Emilie16/HiRel/TODOList.txt

Documentation:
	Analyse des performances attendues	:	Yann	
	Schéma électrique			:	Yann OK	
	Routage					:	Yann OK
	FMECA					:	Yann OK	
	Analyse de stress des composants (PSA)	:	Yann OK
	Dimmensionnement du filtre passe-bas	:	Yann OK	
	Circuit de mesure de rotation à 
	redondance froide			:	Yann OK
	Nombre de pannes par milliard d'heures	:	Yann OK
	Environnement des test			: 	Yann OK	
	Plan de test				:	Yann OK	
	Procédure de test			:	Yann OK

	Choix du capteur			:	Emilie	OK
	Schéma bloc de la chaîne de mesure	:	Emilie	OK
	Budget de la chaîne de mesure		:	Emilie	OK
	Dissipation de chaleur			:	Emilie	OK
	Analyse Monté-Carlo			:	Emilie	OK
	Détermination des paramètres à 
	considérer				:	Emilie 	OK
	Détermination des performances à
	analyser				:	Emilie 	OK
	Évaluation des résultats		:	Emilie 	OK
	Simulation VHDL				:	Emilie	OK
	Matrice de conformité			: 	Emilie	OK
	Banc de test				: 	Emilie	OK	
	Circuit AMBA				:	Emilie	OK
	Simulation du circuit AMBA		:	Emilie	OK
	Périphérique pour convertisseur A/D	:	Emilie	OK
	Machine d'état du contrôleur ADC	:	Emilie	OK
	Codage de la machine d'états		:	Emilie	OK
	Registre à décalage			:	Emilie	OK
	Machine d'état avec contraintes SEU	:	Emilie	OK
	Décodeur de Hamming			:	Emilie	OK
	Estimation du taux de SEU par jour	:	Emilie	OK
	Alimentation FPGA			:	Emilie	OK
	Entrées / sorties du circuit		:	Emilie	OK
