Emilie16/HiRel/HiRelRapport_CourantTension_Maret_Gsponer/PSA/Table_PSA.xls

Circuit Name | Item | Type - Value | Parameter | Rated Value | Derating | Allowed Value | Value | Stress | Status
CanSat_sensor | R16 | Résistance 0.1 ohms 0.5W | V_max | 100 V | 80% | 80 V | 5 V | 6.2% | ok
 |  |  | Pwd_max | 500 mW | 50% | 250 mW | 240.00 mW | 96.0% | ok
 |  |  | Tcase_max | 155 °C | - | 110 °C | 80.2 °C | 72.9% | ok
CanSat_sensor | R17,R19 | Résistance 100 ohms | V_max | 150 V | 80% | 120 V | 5 V | 4.2% | ok
 |  |  | Pwd_max | 125 mW | 50% | 62.5 mW | 1.00 mW | 1.6% | ok
 |  |  | Tcase_max | 155 °C | - | 110 °C | 80.2 °C | 72.9% | ok
CanSat_sensor | R18,R20 | Résistance 20k | V_max | 150 V | 80% | 120 V | 5 V | 4.2% | ok
 |  |  | Pwd_max | 125 mW | 50% | 62.5 mW | 1.00 mW | 1.6% | ok
 |  |  | Tcase_max | 155 °C | - | 110 °C | 80.2 °C | 72.9% | ok
CanSat_sensor | R8..15 | Résistance 47 ohms | V_max | 150 V | 80% | 120 V | 5 V | 4.2% | ok
 |  |  | Pwd_max | 125 mW | 50% | 62.5 mW | 5.00 mW | 8.0% | ok
 |  |  | Tcase_max | 155 °C | - | 110 °C | 80.2 °C | 72.9% | ok
CanSat_sensor | R5 | Résistance 1k | V_max | 150 V | 80% | 120 V | 5 V | 4.2% | ok
 |  |  | Pwd_max | 125 mW | 50% | 62.5 mW | 10.00 mW | 16.0% | ok
 |  |  | Tcase_max | 155 °C | - | 110 °C | 80.2 °C | 72.9% | ok
CanSat_sensor | R2 | Résistance 24k | V_max | 150 V | 80% | 120 V | 3.3 V | 2.8% | ok
 |  |  | Pwd_max | 125 mW | 50% | 62.5 mW | 1.00 mW | 1.6% | ok
 |  |  | Tcase_max | 155 °C | - | 110 °C | 80.2 °C | 72.9% | ok
CanSat_sensor | R6,R7,R1 | Résistance 75k | V_max | 150 V | 80% | 120 V | 5 V | 4.2% | ok
 |  |  | Pwd_max | 125 mW | 50% | 62.5 mW | 10.00 mW | 16.0% | ok
 |  |  | Tcase_max | 155 °C | - | 110 °C | 80.2 °C | 72.9% | ok
CanSat_sensor | R3,R4 | Résistance 270 ohms | V_max | 150 V | 80% | 120 V | 5 V | 4.2% | ok
 |  |  | Pwd_max | 330 mW | 50% | 165 mW | 1.00 mW | 0.6% | ok
 |  |  | Tcase_max | 155 °C | - | 110 °C | 80.2 °C | 72.9% | ok
CanSat_sensor | C10 | Condensateur Tantal 1uF | V_max | 20 V | 60% | 12 V | 5 V | 41.7% | ok
 |  |  | Tcase_max | 125 °C | - | 110 °C | 76 °C | 69.1% | ok
CanSat_sensor | C13 | Condensateur Tantal 100uF | V_max | 6.3 V | 60% | 3.78 V | 5 V | 132.3% | Nok
 |  |  | Tcase_max | 125 °C | - | 110 °C | 76 °C | 69.1% | ok
CanSat_sensor | C9,C11 | Condensateur Tantal 2.2uF | V_max | 16 V | 60% | 9.6 V | 10 V | 104.2% | Nok
 |  |  | Tcase_max | 125 °C | - | 110 °C | 76 °C | 69.1% | ok
CanSat_sensor | C7,C8 | Condensateur céramique 3.3uF | V_max | 16 V | 60% | 9.6 V | 5 V | 52.1% | ok
 |  |  | Tcase_max | 125 °C | - | 110 °C | 76 °C | 69.1% | ok
CanSat_sensor | C4 | Condensateur céramique 100pF | V_max | 50 V | 60% | 30 V | 5 V | 16.7% | ok
 |  |  | Tcase_max | 125 °C | - | 110 °C | 76 °C | 69.1% | ok
CanSat_sensor | C6,C14,C15,C16,C17,C19 | Condensateur céramique 100nF | V_max | 25 V | 60% | 15 V | 5 V | 33.3% | ok
 |  |  | Tcase_max | 125 °C | - | 110 °C | 76 °C | 69.1% | ok
CanSat_sensor | C12,C18,C2 | Condensateur céramique 1uF | V_max | 16 V | 60% | 9.6 V | 5 V | 52.1% | ok
 |  |  | Tcase_max | 125 °C | - | 110 °C | 76 °C | 69.1% | ok
CanSat_sensor | C1,C3,C5 | Condensateur céramique 4.7uF | V_max | 16 V | 60% | 9.6 V | 5 V | 52.1% | ok
 |  |  | Tcase_max | 125 °C | - | 110 °C | 76 °C | 69.1% | ok
CanSat_sensor | U6 | OP184 | Vpos_max | 36 V | 90% | 32.4 V | 5 V | 15.4% | ok
 |  |  | Iout_max | 10.00 mA | 80% | 8 mA | 5 mA | 62.5% | ok
 |  |  | Tj_max | 150 °C | - | 110 °C | 76.4 °C | 69.5% | ok
 |  |  | Pwd_max | 100 mW | 80% | 80 mW | 50.00 mW | 62.5% | ok
 |  |  | Tcase_max | 125 °C | - | 125 °C | 86 °C | 68.8% | ok
 |  |  | Vin_max | 36 V | 70% | 25.2 V | 5 V | 19.8% | ok
CanSat_sensor | U5 | Convertisseur A/D ADS1282-HT | Vpos_max | 5.25 V | 90% | 4.725 V | 5 V | 105.8% | Nok
 |  |  | Pwd_max | 56 mW | 90% | 50.4 mW | 50.00 mW | 99.2% | ok
 |  |  | Tcase_max | 210 °C | - | 210 °C | 86 °C | 41.0% | ok
 |  |  | Vin_max | 5 V | <=Vsupply |  | 5 V |  | ok
 |  |  | Iout_max |  | 80% | 0 mA | SPI | #VALUE! | Nok
CanSat_sensor | U3 | MAX865 | Vpos_max | 24 V | 90% | 21.6 V | 5 V | 23.1% | ok
 |  |  | Iout_max | 20.00 mA | 80% | 16 mA | 10 mA | 62.5% | ok
 |  |  | Tj_max | 160 °C | - | 110 °C | 76.4 °C | 69.5% | ok
 |  |  | Pwd_max | 330 mW | 25% | 82.5 mW | 50.00 mW | 60.6% | ok
 |  |  | Tcase_max | 125 °C | - | 125 °C | 86 °C | 68.8% | ok
 |  |  | Vin_max | 6.2 V | 100% | 6.2 V | 5 V | 80.6% | ok
CanSat_sensor | U4 | MAX6350 | Vpos_max | 40 V | 90% | 36 V | 5 V | 13.9% | ok
 |  |  | Iout_max | 15.00 mA | 80% | 12 mA | 10 mA | 83.3% | ok
 |  |  | Tj_max | 150 °C | - | 110 °C | 76.4 °C | 69.5% | ok
 |  |  | Pwd_max | 727 mW | 25% | 181.75 mW | 75.00 mW | 41.3% | ok
 |  |  | Tcase_max | 125 °C | - | 125 °C | 86 °C | 68.8% | ok
CanSat_sensor | U2 | FTDI FT232RL | Vpos_max | 6 V | 90% | 5.4 V | 5 V | 92.6% | ok
 |  |  | Iout_max | 24.00 mA | 80% | 19.2 mA | 10 mA | 52.1% | ok
 |  |  | Tj_max | 150 °C | - | 110 °C | 76.4 °C | 69.5% | ok
 |  |  | Pwd_max | 500 mW | 80% | 400 mW | 50.00 mW | 12.5% | ok
 |  |  | Tcase_max | 85 °C | - | 85 °C | 85 °C | 100.0% | ok
 |  |  | Vin_max | 6.5 V | <=Vsupply |  | 5 V |  | ok
CanSat_sensor | U1 | AP7361 | Vpos_max | 6.5 V | 90% | 5.85 V | 5 V | 85.5% | ok
 |  |  | Iout_max | 1000.00 mA | 80% | 800 mA | 15 mA | 1.9% | ok
 |  |  | Tj_max | 150 °C | - | 110 °C | 76.4 °C | 69.5% | ok
 |  |  | Pwd_max | 1100 mW | 25% | 275 mW | 100.00 mW | 36.4% | ok
 |  |  | Tcase_max | 125 °C | - | 125 °C | 86 °C | 68.8% | ok
 |  |  | Vin_max | 6.8 V | <=Vsupply |  | 5 V |  | ok
CanSat_sensor | D1,D2 | LED verte | Vrev_max | 5 V | 75% | 3.75 V | 5 V | 133.3% | Nok
 |  |  | Tj_max | 85 °C |  | 110 °C | 76 °C |  | Nok
 |  |  | Pwd_max | 60 mW | 50% | 30 mW | 40.00 mW | 133.3% | Nok
 |  |  | I_max | 25.00 mA | 50% | 12.5 mA | 11.00 mA | 88.0% | ok
CanSat_sensor | J1 | USB Connectors 5P MINI TYPE B | I_max | 1800.00 mA | 50% | 900 mA | 500.00 mA | 55.6% | ok
CanSat_sensor | P1 | Header 3 positions | I_max | 3000.00 mA | 50% | 1500 mA | 300.00 mA | 20.0% | ok
CanSat_sensor | BOT,TOP | Header 2rows 6positions 2.54mm | I_max | 3000.00 mA | 50% | 1500 mA | 20.00 mA | 1.3% | ok
CanSat_sensor | 5V,GND,3.3V,SHU,cur,char,ref | Pointes de test | I_max | 1000.00 mA | 50% |  | 10.00 mA |  | ok
