Emilie16/HiRel/HiRelRapport_CourantTension_Maret_Gsponer/VHDL/CanSat/ads1282_tb.pdf

Package List
LIBRARY ieee;
USE ieee.std_logic_1164.all; USE ieee.numeric_std.ALL;

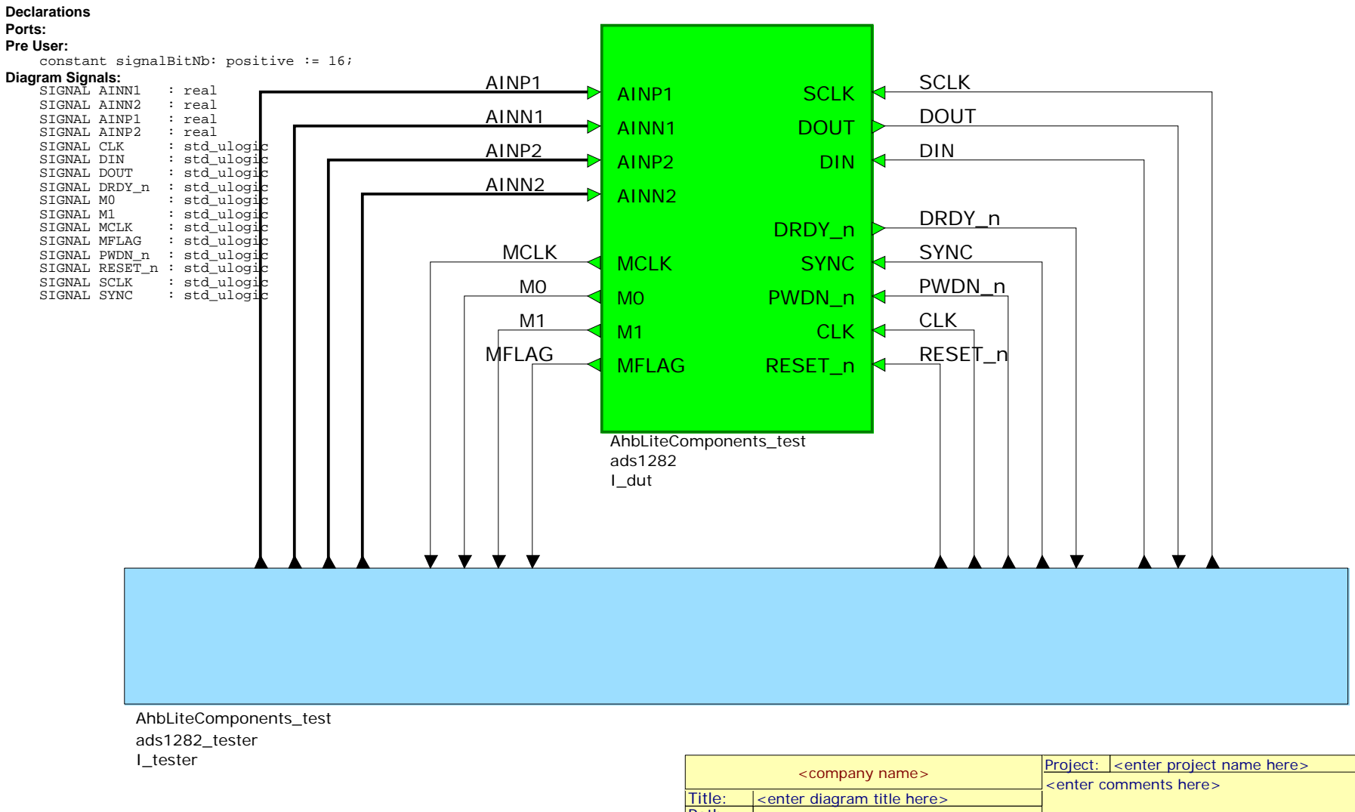
[picture p46: figure]
AhbLiteComponents_test ads1282 I_dut; RESET_n; AINP1; AINN1; AINP2; AINN2; MCLK; MFLAG MFLAG; constant signalBitNb: positive := 16;; SIGNAL AINP1; : real; Declarations Ports: Pre User:; Diagram Signals:; SIGNAL AINN2; SIGNAL AINN1; SIGNAL RESET_n : std_ulogic; SIGNAL CLK; : std_ulogic; SIGNAL PWDN_n : std_ulogic; SIGNAL SYNC; SIGNAL DRDY_n : std_ulogic; SIGNAL DIN; SIGNAL DOUT; SIGNAL SCLK; SIGNAL MFLAG; SIGNAL M1; SIGNAL M0; SIGNAL MCLK; SIGNAL AINP2; CLK; DOUT; SCLK; SYNC; DRDY_n; DIN; PWDN_n; AhbLiteComponents_test ads1282_tester I_tester; Project:; Title:; <enter diagram title here>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

Path: | <<-- more -->>
Edited: | by francois on 07 avr. 2016

<enter project name here> <company name>

AhbLiteComponents_test/ads1282_tb/struct

Printed by francois on 14.04.2016 at 14:47:43 | Page 1 of 1
