Emilie16/HiRel/HiRelRapport_CourantTension_Maret_Gsponer/EffetRadiations/SEU.xls

 |  | Part Type : Slide exercise
LET_th [MeV/mg/cm2] |  | 60
Area for 1 bit [cm2/bit] |  | 2e-07
Environment: |  | METOP
 |  | Flux /m2 /sr /s | Flux /m2 /sr /MeV | Flux /cm2/day | SEU /bit/day
Galactic cosmic rays, for LETth = 60 |  | 1.5e-08 |  | 1.628601632e-06 | 3.257203263e-13
Solar flare, for LETth = 60 |  | 2e-05 |  | 0.002171468842 | 4.342937684e-10
Total events for non permanent flux [/bit/day] |  | 4.342937684e-10
Total events for continuous flux [/bit/day] |  | 3.257203263e-13
SEU rate for the mission (5 years, 5 days solar flare) [/bit/day] |  | 1.510777803e-12
PARAMETERS | BIT QTY | SEU / DAY
Registres: (4*32bits) | 128 | 1.933795588e-10
FSM: 10bit | 10 | 1.510777803e-11
Compteur: 32bits | 32 | 4.834488971e-11
Total SEU/day for the mission (5 years, 5 days solar flare) | 170 | 2.568322266e-10
