Emilie16/HiRel/HiRelRapport_CourantTension_Maret_Gsponer/WCA/AnalyseMonteCarlo_Shunt.xls

MonteCarlito 1.05
Martin Auer, 2004, 2005
Distributed under terms of GNU General Public License
www.montecarlito.com
Instructions: |  |  |  |  | Examples:
1. Put all N formulas you want to simulate next to each other, preceded by the number of trials you want to run. |  |  |  |  | a) Select range I11:K13; press Ctrl+W.
2. Select the N+1 cells and the 7x(N+1) cells beneath (indicated by frame). |  |  |  |  |  | 100 | 0.0812 | 2.3192
 |  |  |  |  |  | Mean | 0.4658 | 0.1757
3. Run macro "simulate" or press Ctrl+W to run simulation. Result: |  |  |  |  |  | Standard error | 0.0291 | 0.1074
 | 1000 | 0.4233 | 71.0647 | 1.0501
 | Mean | 0.5089 | 2446.5257 | -0.0185 | b) Select range I18:J21; press Ctrl+W (a new workbook will be created with histogram).
 | Standard error | 0.0092 | 148.0641 | 0.0305
 | Median | 0.5162 | 168.0721 | -0.0177 |  | 1000 | 0.962713925
 | Standard deviation | 0.2907 | 4682.1995 | 0.9656 |  | Mean | 0.007001337064
 | Variance | 0.0845 | 21922991.8705 | 0.9324 |  | Standard error | 0.03242025187
 | Skewness | -0.0408 | 2.3254 | -0.0604 |  | Median | -0.03325635598
 | Kurtosis | 1.7716 | 7.6445 | 2.8416
 |  |  |  |  |  |  | Rsense | R3 | R1 | Gain
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
