Emilie16/HiRel/HiRelRapport_CourantTension_Maret_Gsponer/Circuitmaker/pcbschema_1.png

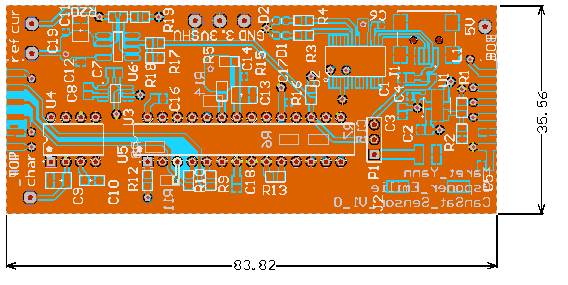
HiRelRapport_CourantTension_Maret_Gsponer/Circuitmaker/pcbschema_1.png
