Emilie16/HiRel/HiRelRapport_CourantTension_Maret_Gsponer/Circuitmaker/pcbtop.png

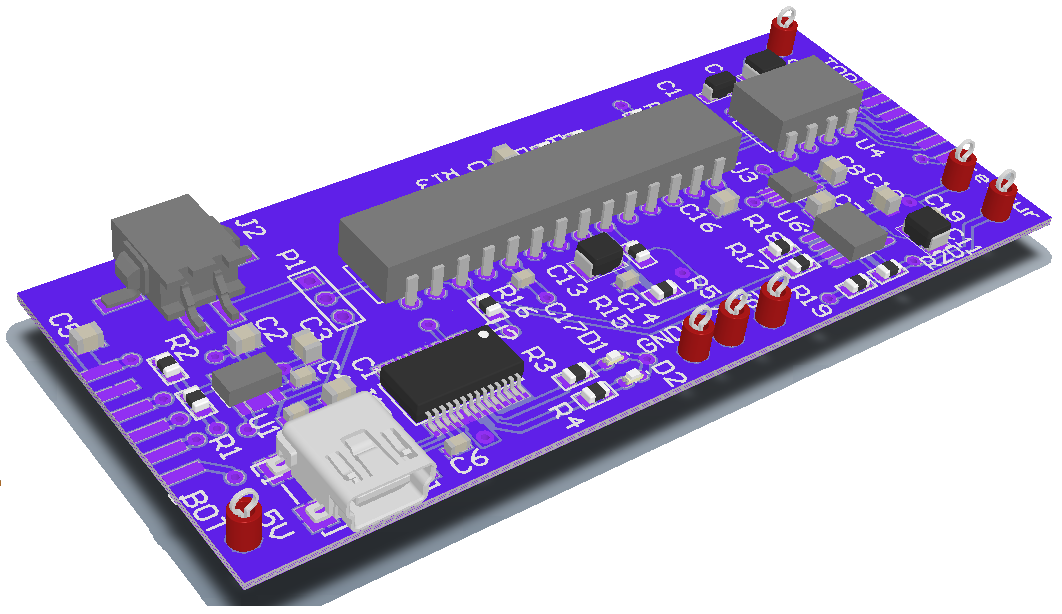
HiRelRapport_CourantTension_Maret_Gsponer/Circuitmaker/pcbtop.png
