Emilie16/HiRel/HiRelRapport_CourantTension_Maret_Gsponer/FMECA/arbre.jpg

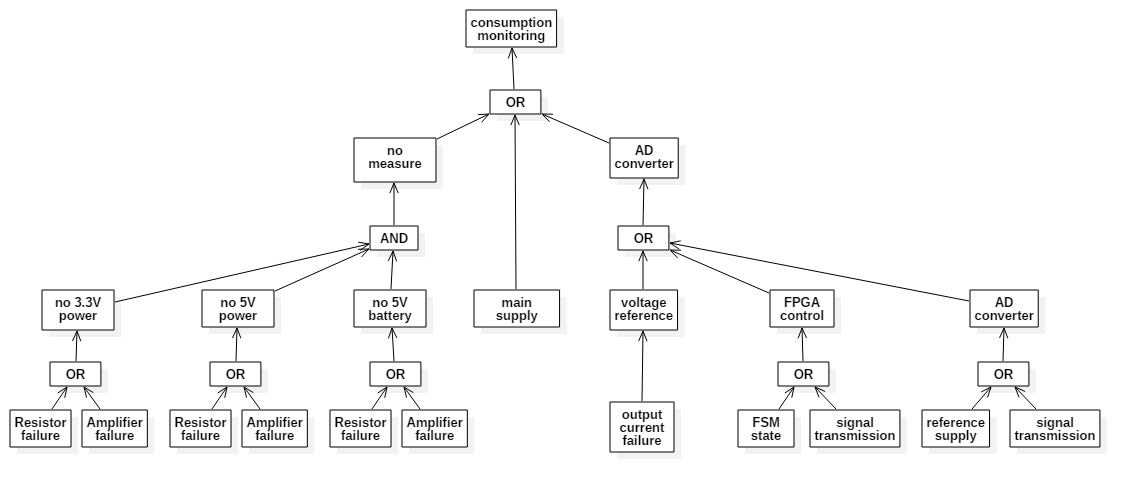
HiRelRapport_CourantTension_Maret_Gsponer/FMECA/arbre.jpg
