Emilie16/HiRel/HiRelRapport_CourantTension_Maret_Gsponer/FRA/redondance_froide.jpg

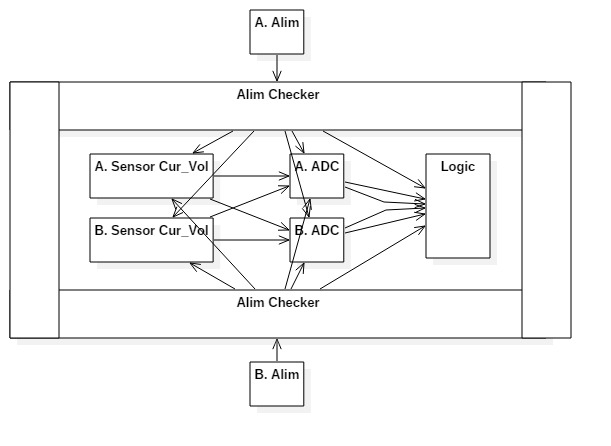
HiRelRapport_CourantTension_Maret_Gsponer/FRA/redondance_froide.jpg
