Emilie16/HiRel/HiRelRapport_CourantTension_Maret_Gsponer/FRA/Rel_components.xls

Sheet: sans_redondance
# | QTY | REFDES | DEVICE | VALUE | λb | C1 | C2 | πT | πE | πQ | πL | πS | πR | πC | πCV | λP | λe
1 | 20 | R1…20 | Ceramic - 0805 |  | 0.00011 |  |  |  | 0.5 | 1 |  |  | 1 |  |  | 5.5e-05 | 0.0011
2 | 6 |  | Ceramic - 0603 |  | 0.00089 |  |  |  | 0.5 | 1 |  |  |  |  | 1 | 0.000445 | 0.00267
3 | 9 |  | Ceramic - 0805 |  | 0.00089 |  |  |  | 0.5 | 1 |  |  |  |  | 1 | 0.000445 | 0.004005
4 | 1 |  | Tantal - A case |  | 0.022 |  |  |  | 0.4 | 1 |  |  |  |  | 1 | 0.0088 | 0.0088
5 | 2 |  | Tantal - B case |  | 0.022 |  |  |  | 0.4 | 1 |  |  |  |  | 1 | 0.0088 | 0.0176
6 | 1 | U6 | OP184 | Ampli op |  | 0.02 | 0.019 | 0.1 | 0.5 | 1 | 1 |  |  |  |  | 0.0115 | 0.0115
7 | 1 | U5 | Convertisseur A/D ADS1282-HT | Analogique to digital |  | 0.6 | 0.056 | 0.1 | 0.5 | 1 | 1 |  |  |  |  | 0.088 | 0.088
8 | 1 | U3 | MAX865 | Doubleur de tension |  | 0.04 | 0.026 | 0.1 | 0.5 | 1 | 1 |  |  |  |  | 0.017 | 0.017
9 | 1 | U4 | MAX6350 | Régulateur de tension 5V |  | 0.04 | 0.026 | 0.1 | 0.5 | 1 | 1 |  |  |  |  | 0.017 | 0.017
10 | 1 | U2 | FTDI FT232RL | USB to UART |  | 0.02 | 0.019 | 0.1 | 0.5 | 1 | 1 |  |  |  |  | 0.0115 | 0.0115
11 | 1 | U1 | AP7361 | Convertisseur DC/DC Adj.1V to 5V |  | 0.04 | 0.026 | 0.1 | 0.5 | 1 | 1 |  |  |  |  | 0.017 | 0.017
12 | 2 | D1,D2 | LED verte | Indicateur visuel | 0.0038 |  |  | 0.1 | 0.5 | 1 |  |  |  |  |  | 0.0019 | 0.0038
 |  |  |  |  |  |  |  |  |  |  |  |  |  |  |  | λPtot | 0.199975

Sheet: avec_redondance
# | QTY | REFDES | DEVICE | VALUE | λb | C1 | C2 | πT | πE | πQ | πL | πS | πR | πC | πCV | λP | λe
1 | 20 | R1…20 | Ceramic - 0805 |  | 0.00011 |  |  |  | 0.5 | 1 |  |  | 1 |  |  | 5.5e-05 | 0.0011
2 | 6 |  | Ceramic - 0603 |  | 0.00089 |  |  |  | 0.5 | 1 |  |  |  |  | 1 | 0.000445 | 0.00267
3 | 9 |  | Ceramic - 0805 |  | 0.00089 |  |  |  | 0.5 | 1 |  |  |  |  | 1 | 0.000445 | 0.004005
4 | 1 |  | Tantal - A case |  | 0.022 |  |  |  | 0.4 | 1 |  |  |  |  | 1 | 0.0088 | 0.0088
5 | 2 |  | Tantal - B case |  | 0.022 |  |  |  | 0.4 | 1 |  |  |  |  | 1 | 0.0088 | 0.0176
6 | 2 | U6 | OP184 | Ampli op |  | 0.02 | 0.019 | 0.1 | 0.5 | 1 | 1 |  |  |  |  | 0.0115 | 0.023
7 | 2 | U5 | Convertisseur A/D ADS1282-HT | Analogique to digital |  | 0.6 | 0.056 | 0.1 | 0.5 | 1 | 1 |  |  |  |  | 0.088 | 0.176
8 | 2 | U3 | MAX865 | Doubleur de tension |  | 0.04 | 0.026 | 0.1 | 0.5 | 1 | 1 |  |  |  |  | 0.017 | 0.034
9 | 2 | U4 | MAX6350 | Régulateur de tension 5V |  | 0.04 | 0.026 | 0.1 | 0.5 | 1 | 1 |  |  |  |  | 0.017 | 0.034
10 | 1 | U2 | FTDI FT232RL | USB to UART |  | 0.02 | 0.019 | 0.1 | 0.5 | 1 | 1 |  |  |  |  | 0.0115 | 0.0115
11 | 2 | U1 | AP7361 | Convertisseur DC/DC Adj.1V to 5V |  | 0.04 | 0.026 | 0.1 | 0.5 | 1 | 1 |  |  |  |  | 0.017 | 0.034
12 | 2 | D1,D2 | LED verte | Indicateur visuel | 0.0038 |  |  | 0.1 | 0.5 | 1 |  |  |  |  |  | 0.0019 | 0.0038
 |  |  |  |  | λPara | 0.00575 | 0.044 | 0.0085 | 0.0085 | 0.0085
 |  |  |  |  | λPtot |  |  |  |  |  |  |  |  |  |  |  | 0.124725
