Emilie16/HiRel/HiRelRapport_CourantTension_Maret_Gsponer/FMECA/fmeca_table.xlsx

Failure Modes Effects and Criticality Analysis (FMECA)
Product: CanSat |  |  |  |  | Prepared by: Maret Yann |  | Document ref.: 1
Project/Phase: HiRel |  |  |  |  | Approved by: |  | Issue: 0
System/Subsystem/Equipment: Carte mesure de courant tension |  |  |  |  | Date:06.04.16 |  | Page 1 of 1
Ident. | Item/ | Function | Failure mode | Failure cause | Mission phase/ | Failure effects | Failure detection method/ observable symptoms | Compensation provisions | Severity SN | Occurrence PN | Detection DN | Criticality Number CN | Corrective actions | Remarks
number | block |  |  |  | Op. mode | a. Local effects
 |  |  |  |  |  | b. End effects
 | Carte capteur | mesure de courant-tension | Plus de tension | Batterie morte, plus de connexion de la batterie |  | Arrêt complet du système | Plus de fonctionnement |  | 4 | 1 | 1 | 4 | Changement de batterie
 |  |  | Mort du convertisseur AD | Court-circuit, défaut de fabrication,… |  | Plus de valeur mesurable sur la FPGA | Plus de valeurs de courant tension mesurées |  | 2 | 1 | 2 | 4 | Remplacement du convertisseur
 |  |  | Défaillance de l’Ampli OP | Mauvais gain, mauvaises résistances |  | Plus de valeurs mesurables |  |  | 2 | 1 | 2 | 4 | Remplacement des résistances ou ampli op
 |  |  | Court-circuit de la résistance de shunt | Dissipation trop importante de la résistance |  | Arrêt complet du système | Plus de fonctionnement |  | 1 | 1 | 1 | 1 | Remplacement de la résistance shunt
 |  |  | Mort de l’alimentation stabilisée | Court-circuit |  | Plus de valeurs échantillonnées par le convertisseur |  |  | 4 | 1 | 1 | 4 | Remplacement de l’alimentation
 |  |  | Contraintes mécanique trop importantes | Décollage, atterrissage, accélération |  | Arrêt complet du système | Plus de fonctionnement |  | 4 | 1 | 1 | 4 | Changement de carte
 |  |  | Trop de rayonnement magnétique | Rayon du soleil |  | Arrêt complet du système |  |  | 4 | 1 | 2 | 8
 |  |  | Trop d’humidité | Nuages pluvieux |  | Arrêt complet du système |  |  | 4 | 1 | 1 | 4
 |  |  | Trop de courant consommé | Stress de l’électronique |  | Arrêt complet du système |  |  | 4 | 1 | 1 | 4
 |  |  | Trop de dissipation de chaleur, puissance | Isolation |  | Arrêt complet du système |  |  | 4 | 1 | 1 | 4
