Emilie16/HiRel/HiRelRapport_CourantTension_Maret_Gsponer/BudgetChaineMesure/Budgets.xls

Sheet: Power, components
Consumption in sleep mode | Currents in mA, unless otherwise noted
 | Total = Sum(typ) + Sqrt(Sum((Max-Typ)^2))
Sleep mode current consumption [mA] | Fonction | # | 10V | 10V | 5V | 5V | 3.3V | 3.3V | 2V | 2V | Sleep mode power consumption [mW] | Fonction | # | 10V | 10V | 5V | 5V | 3.3V | 3.3V | 2V | 2V
 |  |  | typ | max | typ | max | typ | max | typ | max |  |  |  | typ | max | typ | max | typ | max | typ | max
OP184 | Ampli op | 1 | - | - | 1.45 | 1.45 | - | - | - | - | OP184 | Ampli op | 1 | - | - | 7.25 | 7.25 | - | - | - | -
Convertisseur A/D ADS1282-HT | Digital part | 1 | - | - | - | - | 0.07 | 0.17 | - | - | Convertisseur A/D ADS1282-HT | Digital part | 1 | - | - | - | - | 0.24 | 0.58 | - | -
Convertisseur A/D ADS1282-HT | Analogic part | 1 | - | - | 0.07 | 0.25 | - | - | - | - | Convertisseur A/D ADS1282-HT | Analogic part | 1 | - | - | 0.34 | 1.25 | - | - | - | -
MAX865 | Doubleur de tension | 1 | - | - | 0.60 | 1.15 | - | - | - | - | MAX865 | Doubleur de tension | 1 | - | - | 3.00 | 5.75 | - | - | - | -
MAX6350 | Régulateur de tension 5V | 1 | 2.00 | 3.30 | - | - | - | - | - | - | MAX6350 | Régulateur de tension 5V | 1 | 20.00 | 33.00 | - | - | - | - | - | -
FTDI FT232RL | USB to UART | 1 | - | - | 0.07 | 0.10 | - | - | - | - | FTDI FT232RL | USB to UART | 1 | - | - | 0.35 | 0.50 | - | - | - | -
AP7361 | Convertisseur DC/DC Adj.1V to 5V | 1 | - | - | 0.07 | 0.09 | - | - | - | - | AP7361 | Convertisseur DC/DC Adj.1V to 5V | 1 | - | - | 0.35 | 0.45 | - | - | - | -
LED verte | Indicateur visuel | 2 | - | - | - | - | - | - | 0.00 | 0.00 | LED verte | Indicateur visuel | 2 | - | - | - | - | - | - | 0.00 | 0.00
total in mA |  |  | 3.30 |  | 2.84 |  | 0.17 |  | 0.00 |  | total in mW |  |  | 33.00 |  | 14.19 |  | 0.58 |  | 0.00
+10% margin |  |  | 3.63 |  | 3.12 |  | 0.19 |  | 0.00 |  | +10% margin |  |  | 36.30 |  | 15.61 |  | 0.64 |  | 0.00
total in mA |  |  |  | 6.313451548 | mA |  | +10% margin |  | 6.944796703 | mA | total in mW |  |  |  | 47.76975774 | mW |  | +10% margin |  | 52.54673352 | mW
Consumption in active mode | Currents in mA, unless otherwise noted
 | Total = Sum(typ) + Sqrt(Sum((Max-Typ)^2))
Active mode current consumption [mA] | Fonction | # | 10V | 10V | 5V | 5V | 3.3V | 3.3V | 2V | 2V | Active mode power consumption [mW] | Fonction | # | 5V | 5V | 5V | 5V | 3.3V | 3.3V | 2V | 2V
 |  |  | typ | max | typ | max | typ | max | typ | max |  |  |  | typ | max | typ | max | typ | max | typ | max
OP184 | Ampli op | 1 | - | - | 1.45 | 1.45 | - | - | - | - | OP184 | Ampli op | 1 | - | - | 7.25 | 7.25 | - | - | - | -
Convertisseur A/D ADS1282-HT | Digital part | 1 | - | - | - | - | 0.60 | 1.50 | - | - | Convertisseur A/D ADS1282-HT | Digital part | 1 | - | - | - | - | 1.98 | 4.95 | - | -
Convertisseur A/D ADS1282-HT | Analogic part | 1 | - | - | 4.50 | 7.20 | - | - | - | - | Convertisseur A/D ADS1282-HT | Analogic part | 1 | - | - | 22.50 | 36.00 | - | - | - | -
MAX865 | Doubleur de tension | 1 | - | - | 0.60 | 1.15 | - | - | - | - | MAX865 | Doubleur de tension | 1 | - | - | 3.00 | 5.75 | - | - | - | -
MAX6350 | Régulateur de tension 5V | 1 | 2.00 | 3.30 | - | - | - | - | - | - | MAX6350 | Régulateur de tension 5V | 1 | 20.00 | 33.00 | - | - | - | - | - | -
FTDI FT232RL | USB to UART | 1 | - | - | 15.00 | 15.00 | - | - | - | - | FTDI FT232RL | USB to UART | 1 | - | - | 75.00 | 75.00 | - | - | - | -
AP7361 | Convertisseur DC/DC Adj.1V to 5V | 1 | - | - | 0.07 | 0.09 | - | - | - | - | AP7361 | Convertisseur DC/DC Adj.1V to 5V | 1 | - | - | 0.35 | 0.45 | - | - | - | -
LED verte | Indicateur visuel | 2 | - | - | - | - | - | - | 5.00 | 25.00 | LED verte | Indicateur visuel | 2 | - | - | - | - | - | - | 10.00 | 50.00
total in mA |  |  | 3.30 |  | 24.38 |  | 1.50 |  | 30.00 |  | total in mW |  |  | 33.00 |  | 121.88 |  | 4.95 |  | 60.00
+10% margin |  |  | 3.63 |  | 26.81 |  | 1.65 |  | 33.00 |  | +10% margin |  |  | 36.30 |  | 134.07 |  | 5.44 |  | 66.00
total in mA |  |  |  | 59.17552173 | mA |  | +10% margin |  | 65.0930739 | mA | total in mW |  |  |  | 219.8276086 | mW |  | +10% margin |  | 241.8103695 | mW
Consumption of basis power circuit
Active mode current consumption [mA] | Fonction | # | 5V | 5V | 2V | 2V
 |  |  | typ | max | typ | max
FTDI FT232RL | USB to UART | 1 | 15.00 | 15.00 | - | -
AP7361 | Convertisseur DC/DC Adj.1V to 5V | 1 | 0.07 | 0.09 | - | -
LED verte | Indicateur visuel | 2 | - | - | 5.00 | 25.00
total in mA |  |  | 15.09 |  | 30.00
+10% margin |  |  | 16.60 |  | 33.00
total in mA |  |  |  | 45.09 | mA |  | +10% margin |  | 49.599 | mA

Sheet: Area
Area budget by component |  |  |  |  |  |  |  |  | Area by function
Linear dimensions in mm, areas in mm^2 |  |  |  |  |  |  |  |  | All areas in mm2.
Component | Function | Package | # on board | Part area | Part area on board | Floor/part area ratio | Floor area on board | Remarks | Functional block | Function | # on bloc | Component area | PCB floor/part area | Total area | Remark
Résistance 0.1 ohms 0.5W | Current sense | 0805 | 1 | 2.50 | 2.50 | 1.50 | 3.75 |  | Power Supply |  |  | 374.271 |  | 645.4791
Résistance 100 ohms | Résistance | 0805 | 2 | 2.50 | 5.00 | 1.50 | 7.50 |  | USB Connectors 5P MINI TYPE B | Usb connector smd | 1 | 37.5 | 4.0 | 150
Résistance 20k | Résistance | 0805 | 2 | 2.50 | 5.00 | 1.50 | 7.50 |  | Condensateur céramique 4.7uF | Filtrage/Découplage | 1 | 2.5 | 1.5 | 3.75
Résistance 47 ohms | Résistance | 0805 | 8 | 2.50 | 20.00 | 1.50 | 30.00 |  | Perle de ferrite | Protection EMC | 1 | 1.28 | 1.5 | 1.92
Résistance 1k | Résistance | 0805 | 1 | 2.50 | 2.50 | 1.50 | 3.75 |  | Header 3 positions | Change battery source | 1 | 10.9278 | 1.5 | 16.3917
Résistance 24k | Résistance | 0805 | 1 | 2.50 | 2.50 | 1.50 | 3.75 |  | Header 2rows 6positions 2.54mm | Connecteurs cartes | 2 | 154.8384 | 1.5 | 232.2576
Résistance 75k | Résistance | 0805 | 3 | 2.50 | 7.50 | 1.50 | 11.25 |  | Header 1row 2position 3mm | Connecteur Batterie | 1 | 147.87 | 1.5 | 221.805
OP184 | Ampli op | SOIC-8 | 1 | 31.00 | 31.00 | 4.00 | 124.00 |  | Pointes de test | Signals measurement | 3 | 19.3548 | 1 | 19.3548
Convertisseur A/D ADS1282-HT | Analogique to digital | CDIP-SB-28 | 1 | 64.68 | 64.68 | 15.00 | 970.20
MAX865 | Doubleur de tension | UMAX-8 | 1 | 15.34 | 15.34 | 4.00 | 61.37 |  | Current measurement |  |  | 2.5 |  | 3.75
MAX6350 | Régulateur de tension 5V | PDIP-8 | 1 | 83.66 | 83.66 | 4.00 | 334.63 |  | Résistance 0.1 ohms 0.5W | Current sense | 1 | 2.5 | 1.5 | 3.75
FTDI FT232RL | USB to UART | SSOP-28 | 1 | 79.56 | 79.56 | 10.00 | 795.60
USB Connectors 5P MINI TYPE B | Usb connector smd | - | 1 | 37.50 | 37.50 | 4.00 | 150.00 |  | Amplifier |  |  | 48.7316 |  | 147.3716
AP7361 | Convertisseur DC/DC Adj.1V to 5V | UDFN-3030-8 | 1 | 9.00 | 9.00 | 4.00 | 36.00 |  | Condensateur céramique 100nF | Filtrage/Découplage | 1 | 1.28 | 1.5 | 1.92
Condensateur Tantal 1uF | Filtrage/Découplage | A case | 1 | 5.12 | 5.12 | 1.50 | 7.68 |  | OP184 | Ampli op | 1 | 31 | 4.0 | 124
Condensateur Tantal 100uF | Filtrage/Découplage | B case | 1 | 9.80 | 9.80 | 1.50 | 14.70 |  | Résistance 100 ohms | Résistance | 2 | 5 | 1.5 | 7.5
Condensateur Tantal 2.2uF | Filtrage/Découplage | B case | 2 | 9.80 | 19.60 | 1.50 | 29.40 |  | Résistance 20k | Résistance | 2 | 5 | 1.5 | 7.5
Perle de ferrite | Protection EMC | 0603 | 1 | 1.28 | 1.28 | 1.50 | 1.92 |  | Pointes de test | Signals measurement | 1 | 6.4516 | 1.0 | 6.4516
Header 3 positions | Change battery source | diam. 2.54mm | 1 | 10.93 | 10.93 | 1.50 | 16.39
Header 1row 2position 3mm | Connecteur Batterie | - | 1 | 147.87 | 147.87 | 1.50 | 221.81 |  | Reference voltage 5V |  |  | 131.2192 |  | 444.3268
Header 2rows 6positions 2.54mm | Connecteurs cartes | - | 2 | 77.42 | 154.84 | 1.50 | 232.26 |  | Condensateur céramique 3.3uF | Filtrage/Découplage | 2 | 5 | 1.5 | 7.5
Pointes de test | Signals measurement | diam. 2.54mm | 4 | 6.45 | 25.81 | 1.00 | 25.81 |  | MAX865 | Doubleur de tension | 1 | 15.3415 | 4.0 | 61.366
LED verte | Indicateur visuel | 0603 | 2 | 1.28 | 2.56 | 1.50 | 3.84 |  | Condensateur Tantal 2.2uF | Filtrage/Découplage | 2 | 19.6 | 1.5 | 29.4
Condensateur céramique 3.3uF | Filtrage/Découplage | 0805 | 2 | 2.50 | 5.00 | 1.50 | 7.50 |  | Condensateur Tantal 1uF | Filtrage/Découplage | 1 | 5.12 | 1.5 | 7.68
Condensateur céramique 100pF | Filtrage/Découplage | 0603 | 1 | 1.28 | 1.28 | 1.50 | 1.92 |  | MAX6350 | Régulateur de tension 5V | 1 | 83.6577 | 4.0 | 334.6308
Condensateur céramique 100nF | Filtrage/Découplage | 0603 | 5 | 1.28 | 6.40 | 1.50 | 9.60 |  | Condensateur céramique 1uF | Filtrage/Découplage | 1 | 2.5 | 1.5 | 3.75
Condensateur céramique 1uF | Filtrage/Découplage | 0805 | 4 | 2.50 | 10.00 | 1.50 | 15.00
Condensateur céramique 4.7uF | Filtrage/Découplage | 0805 | 3 | 2.50 | 7.50 | 1.50 | 11.25 |  | Analogic to digital converter |  |  | 110.82 |  | 1039.41
Résistance 270 ohms | Résistance | 0805 | 2 | 2.50 | 5.00 | 1.50 | 7.50 |  | Convertisseur A/D ADS1282-HT | Analogique to digital | 1 | 64.68 | 15.0 | 970.2
 |  |  |  |  |  |  |  |  | Résistance 1k | Résistance | 1 | 2.5 | 1.5 | 3.75
 |  |  |  |  |  |  |  |  | Condensateur Tantal 100uF | Filtrage/Découplage | 1 | 9.8 | 1.5 | 14.7
 |  |  |  |  |  |  |  |  | Condensateur céramique 100nF | Filtrage/Découplage | 3 | 3.84 | 1.5 | 5.76
Total |  |  |  |  | 778.7218 |  | 3145.8675 | [mm^2] | Condensateur céramique 1uF | Filtrage/Découplage | 2 | 5 | 1.5 | 7.5
Board area =2/3*floor area |  |  |  |  |  |  | 2076.27255 | [mm^2] | Résistance 75k | Résistance | 2 | 5 | 1.5 | 7.5
 |  |  |  |  |  |  |  |  | Résistance 47 ohms | Résistance | 8 | 20 | 1.5 | 30
 |  |  |  |  |  |  |  |  | DC/DC 3.3V converter |  |  | 19 |  | 51
 |  |  |  |  |  |  |  |  | Condensateur céramique 1uF | Filtrage/Découplage | 1 | 2.5 | 1.50 | 3.75
 |  |  |  |  |  |  |  |  | Condensateur céramique 4.7uF | Filtrage/Découplage | 1 | 2.5 | 1.50 | 3.75
 |  |  |  |  |  |  |  |  | Résistance 75k | Résistance | 1 | 2.5 | 1.50 | 3.75
 |  |  |  |  |  |  |  |  | Résistance 24k | Résistance | 1 | 2.5 | 1.50 | 3.75
 |  |  |  |  |  |  |  |  | AP7361 | Convertisseur DC/DC Adj.1V to 5V | 1 | 9 | 4.00 | 36
 |  |  |  |  |  |  |  |  | USB to UART converter |  |  | 92.18 |  | 814.53
 |  |  |  |  |  |  |  |  | Condensateur céramique 100pF | Filtrage/Découplage | 1 | 1.28 | 1.50 | 1.92
 |  |  |  |  |  |  |  |  | FTDI FT232RL | USB to UART | 1 | 79.56 | 10.00 | 795.6
 |  |  |  |  |  |  |  |  | LED verte | Indicateur visuel | 2 | 2.56 | 1.50 | 3.84
 |  |  |  |  |  |  |  |  | Condensateur céramique 100nF | Filtrage/Découplage | 1 | 1.28 | 1.50 | 1.92
 |  |  |  |  |  |  |  |  | Résistance 270 ohms | Résistance | 2 | 5 | 1.50 | 7.5
 |  |  |  |  |  |  |  |  | Condensateur céramique 4.7uF | Filtrage/Découplage | 1 | 2.5 | 1.50 | 3.75
 |  |  |  |  |  |  |  |  | Total |  |  | 778.7218 |  | 3145.8675 | [mm^2]

Sheet: Mass
Mass budget by components
Remarks:
1) CeramicDIL packages will have about 2.2 times the mass of equivalent plastic DIL packages.
2) Flight standard copper thickness on PCB layers (35mm) assumed.
3) Mechanical fixation, e.g. rigidification frames and wedge locks, not considered.
 |  |  |  |  |  |  |  |  | Mass by function
Nominal configuration
All masses in mg. |  |  |  |  |  |  |  |  | All masses in mg.
Component | Function | Package | # on board | Mass / part | Mass / board | Remarks |  |  | Functional block | Function | # on bloc | Component mass | Mass of PCB area | Mass of functional block | Remark
PCB |  | 35mm x 83mm, 4 layers of 35mm Cu | 1 | 14400 | 14400 | # estimated |  |  | Power Supply |  |  | 3901.5 | 2130.08103 | 6031.58103
Solder |  |  | 1 | 1440 | 1440 | # estimated |  |  | USB Connectors 5P MINI TYPE B | Usb connector smd | 1 | 3000 | 495 | 3495
Résistance 0.1 ohms 0.5W | Current sense | 0805 | 1 | 5.5 | 5.5 |  |  |  | Condensateur céramique 4.7uF | Filtrage/Découplage | 1 | 5.5 | 12.375 | 17.875
Résistance 100 ohms | Résistance | 0805 | 2 | 5.5 | 11 |  |  |  | Perle de ferrite | Protection EMC | 1 | 2 | 6.336 | 8.336
Résistance 20k | Résistance | 0805 | 2 | 5.5 | 11 |  |  |  | Header 3 positions | Change battery source | 1 | 20 | 54.09261 | 74.09261
Résistance 47 ohms | Résistance | 0805 | 8 | 5.5 | 44 |  |  |  | Header 2rows 6positions 2.54mm | Connecteurs cartes | 2 | 714 | 766.45008 | 1480.45008
Résistance 1k | Résistance | 0805 | 1 | 5.5 | 5.5 |  |  |  | Header 1row 2position 3mm | Connecteur Batterie | 1 | 100 | 731.9565 | 831.9565
Résistance 24k | Résistance | 0805 | 1 | 5.5 | 5.5 |  |  |  | Pointes de test | Signals measurement | 3 | 60 | 63.87084 | 123.87084
Résistance 75k | Résistance | 0805 | 3 | 5.5 | 16.5
OP184 | Ampli op | SOIC-8 | 1 | 540 | 540 |  |  |  | Current measurement |  |  | 5.5 | 12.375 | 17.875
Convertisseur A/D ADS1282-HT | Analogique to digital | CDIP-SB-28 | 1 | 3000 | 3000 | # estimated |  |  | Résistance 0.1 ohms 0.5W | Current sense | 1 | 5.5 | 12.375 | 17.875
MAX865 | Doubleur de tension | UMAX-8 | 1 | 200 | 200 | # estimated
MAX6350 | Régulateur de tension 5V | PDIP-8 | 1 | 1000 | 1000 |  |  |  | Amplifier |  |  | 584 | 486.32628 | 1070.32628
FTDI FT232RL | USB to UART | SSOP-28 | 1 | 2268 | 2268 |  |  |  | Condensateur céramique 100nF | Filtrage/Découplage | 1 | 2 | 6.336 | 8.336
USB Connectors 5P MINI TYPE B | Usb connector smd | - | 1 | 3000 | 3000 | # estimated |  |  | OP184 | Ampli op | 1 | 540 | 409.2 | 949.2
AP7361 | Convertisseur DC/DC Adj.1V to 5V | UDFN-3030-8 | 1 | 200 | 200 | # estimated |  |  | Résistance 100 ohms | Résistance | 2 | 11 | 24.75 | 35.75
Condensateur Tantal 1uF | Filtrage/Découplage | A case | 1 | 16.2 | 16.2 |  |  |  | Résistance 20k | Résistance | 2 | 11 | 24.75 | 35.75
Condensateur Tantal 100uF | Filtrage/Découplage | B case | 1 | 16 | 16 |  |  |  | Pointes de test | Signals measurement | 1 | 20 | 21.29028 | 41.29028
Condensateur Tantal 2.2uF | Filtrage/Découplage | B case | 2 | 16 | 32
Perle de ferrite | Protection EMC | 0603 | 1 | 2 | 2 |  |  |  | Reference voltage 5V |  |  | 1264.7 | 1466.27844 | 2730.97844
Header 3 positions | Change battery source | diam. 2.54mm | 1 | 20 | 20 | # estimated |  |  | Condensateur céramique 3.3uF | Filtrage/Découplage | 2 | 11 | 24.75 | 35.75
Header 1row 2position 3mm | Connecteur Batterie | - | 1 | 100 | 100 | # estimated |  |  | MAX865 | Doubleur de tension | 1 | 200 | 202.5078 | 402.5078
Header 2rows 6positions 2.54mm | Connecteurs cartes | - | 2 | 357 | 714 |  |  |  | Condensateur Tantal 2.2uF | Filtrage/Découplage | 2 | 32 | 97.02 | 129.02
Pointes de test | Signals measurement | diam. 2.54mm | 4 | 20 | 80 | # estimated |  |  | Condensateur Tantal 1uF | Filtrage/Découplage | 1 | 16.2 | 25.344 | 41.544
LED verte | Indicateur visuel | 0603 | 2 | 20 | 40 | # estimated |  |  | MAX6350 | Régulateur de tension 5V | 1 | 1000 | 1104.28164 | 2104.28164
Condensateur céramique 3.3uF | Filtrage/Découplage | 0805 | 2 | 5.5 | 11 |  |  |  | Condensateur céramique 1uF | Filtrage/Découplage | 1 | 5.5 | 12.375 | 17.875
Condensateur céramique 100pF | Filtrage/Découplage | 0603 | 1 | 2 | 2 |  |  |  |  |  |  |  |  | 0
Condensateur céramique 100nF | Filtrage/Découplage | 0603 | 5 | 2 | 10 |  |  |  | Analogic to digital converter |  |  | 3093.5 | 3430.053 | 6523.553
Condensateur céramique 1uF | Filtrage/Découplage | 0805 | 4 | 5.5 | 22 |  |  |  | Convertisseur A/D ADS1282-HT | Analogique to digital | 1 | 3000 | 3201.66 | 6201.66
Condensateur céramique 4.7uF | Filtrage/Découplage | 0805 | 3 | 5.5 | 16.5 |  |  |  | Résistance 1k | Résistance | 1 | 5.5 | 12.375 | 17.875
Résistance 270 ohms | Résistance | 0805 | 2 | 5.5 | 11 |  |  |  | Condensateur Tantal 100uF | Filtrage/Découplage | 1 | 16 | 48.51 | 64.51
 |  |  |  |  |  |  |  |  | Condensateur céramique 100nF | Filtrage/Découplage | 3 | 6 | 19.008 | 25.008
 |  |  |  |  |  |  |  |  | Condensateur céramique 1uF | Filtrage/Découplage | 2 | 11 | 24.75 | 35.75
 |  |  |  |  |  |  | components only |  | Résistance 75k | Résistance | 2 | 11 | 24.75 | 35.75
Total |  |  |  |  | 27239.7 | [mg] | 11388.7 | [mg] | Résistance 47 ohms | Résistance | 8 | 44 | 99 | 143
 |  |  |  |  |  |  |  |  | DC/DC 3.3V converter |  |  | 222 | 168.3 | 390.3
 |  |  |  |  |  |  |  |  | Condensateur céramique 1uF | Filtrage/Découplage | 1 | 5.5 | 12.375 | 17.875
 |  |  |  |  |  |  |  |  | Condensateur céramique 4.7uF | Filtrage/Découplage | 1 | 5.5 | 12.375 | 17.875
 |  |  |  |  |  |  |  |  | Résistance 75k | Résistance | 1 | 5.5 | 12.375 | 17.875
 |  |  |  |  |  |  |  |  | Résistance 24k | Résistance | 1 | 5.5 | 12.375 | 17.875
 |  |  |  |  |  |  |  |  | AP7361 | Convertisseur DC/DC Adj.1V to 5V | 1 | 200 | 118.8 | 318.8
 |  |  |  |  |  |  |  |  | USB to UART converter |  |  | 2328.5 | 2671.449 | 4999.949
 |  |  |  |  |  |  |  |  | Condensateur céramique 100pF | Filtrage/Découplage | 1 | 2 | 6.336 | 8.336
 |  |  |  |  |  |  |  |  | FTDI FT232RL | USB to UART | 1 | 2268 | 2625.48 | 4893.48
 |  |  |  |  |  |  |  |  | LED verte | Indicateur visuel | 2 | 40 | 12.672 | 52.672
 |  |  |  |  |  |  |  |  | Condensateur céramique 100nF | Filtrage/Découplage | 1 | 2 | 6.336 | 8.336
 |  |  |  |  |  |  |  |  | Résistance 270 ohms | Résistance | 2 | 11 | 8.25 | 19.25
 |  |  |  |  |  |  |  |  | Condensateur céramique 4.7uF | Filtrage/Découplage | 1 | 5.5 | 12.375 | 17.875
 |  |  |  |  |  |  |  |  | Total |  |  | 11399.7 | 10364.86275 | 21764.56275 | [mg]

Sheet: Component
Component | Function | Package | Precision | Temperature range | Vendor | Vendor reference | Manufacturer reference | # on board | Unit price | Price on board
Résistance 0.1 ohms 0.5W | Current sense | 0805 | 1% | -55°C to 155°C | Mouser | 667-ERJ-6BWFR100V | ERJ-6BWFR100V | 1 | 1.18 | 1.18
Résistance 100 ohms | Résistance | 0805 | 1% | -55°C to 155°C | Mouser | 71-CRCW0805-100-E3 | CRCW0805100RFKEA | 2 | 0.1 | 0.2
Résistance 20k | Résistance | 0805 | 1% | -55°C to 155°C | Mouser | 71-CRCW0805-20K-E3 | CRCW080520K0FKEA | 2 | 0.1 | 0.2
Résistance 47 ohms | Résistance | 0805 | 1% | -55°C to 155°C | Mouser | 71-CRCW0805-47-E3 | CRCW080547R0FKEA | 8 | 0.1 | 0.8
Résistance 1k | Résistance | 0805 | 1% | -55°C to 155°C | Mouser | 71-CRCW0805-1.0K-E3 | CRCW08051K00FKEA | 1 | 0.1 | 0.1
Résistance 24k | Résistance | 0805 | 1% | -55°C to 155°C | Mouser | 71-CRCW0805-24K-E3 | CRCW080524K0FKEA | 1 | 0.1 | 0.1
Résistance 75k | Résistance | 0805 | 1% | -55°C to 155°C | Mouser | 71-CRCW0805-75K | CRCW080575K0FKTA | 3 | 0.14 | 0.42
OP184 | Ampli op | SOIC-8 | - | -40°C to 125°C | Mouser | 584-OP184ESZ | OP184ESZ | 1 | 6.04 | 6.04
Convertisseur A/D ADS1282-HT | Analogique to digital | CDIP-SB-28 | 0.01% | -55°C to 210°C | Mouser | 595-ADS1282SJDJ | ADS1282SJDJ | 1 | 222.64 | 222.64
MAX865 | Doubleur de tension | UMAX-8 | - | -40°C to 85°C | Mouser | 700-MAX865EUAT | MAX865EUA+T | 1 | 3.23 | 3.23
MAX6350 | Régulateur de tension 5V | PDIP-8 | 0.02% | -40°C to 85°C | Mouser | 700-MAX6350EPA | MAX6350EPA+ | 1 | 11.79 | 11.79
FTDI FT232RL | USB to UART | SSOP-28 | - | -40°C to 85°C | Mouser | 895-FT232RL | FT232RL-REEL | 1 | 4.53 | 4.53
USB Connectors 5P MINI TYPE B | Usb connector smd | - | - | - | Mouser | 649-10104111-0001LF | 10104111-0001LF | 1 | 0.717 | 0.717
AP7361 | Convertisseur DC/DC Adj.1V to 5V | UDFN-3030-8 | 2% | -40°C to 85°C | Mouser | 621-AP7361-FGE-7 | AP7361-FGE-7 | 1 | 0.524 | 0.524
Condensateur Tantal 1uF | Filtrage/Découplage | A case | 10% | -55°C to 125°C | Mouser | 581-TAJA105K020 | TAJA105K020RNJ | 1 | 0.604 | 0.604
Condensateur Tantal 100uF | Filtrage/Découplage | B case | 10% | -55°C to 125°C | Mouser | 581-TAJB107K006R | TAJB107K006RNJ | 1 | 1.04 | 1.04
Condensateur Tantal 2.2uF | Filtrage/Découplage | B case | 10% | -55°C to 125°C | Mouser | 581-TAJB225K016R | TAJB225K016RNJ | 2 | 0.6074 | 1.2148
Perle de ferrite | Protection EMC | 0603 | 25% | -55°C to 125°C | Mouser | 81-BLM18PG121SN1D | BLM18PG121SN1D | 1 | 0.1 | 0.1
Header 3 positions | Change battery source | diam. 2.54mm | - | - | Mouser | 571-5-146281-3 | 5-146281-3 | 1 | 0.279 | 0.279
Header 1row 2position 3mm | Connecteur Batterie | - | - | - | Mouser | 571-2029030-2 | 2029030-2 | 1 | 1.03 | 1.03
Header 2rows 6positions 2.54mm | Connecteurs cartes | - | - | -40°C to 105°C | Mouser | 855-M20-9980346 | M20-9980346 | 2 | 0.239 | 0.478
Pointes de test | Signals measurement | diam. 2.54mm | - | - | Mouser | 534-5001 | 5001 | 4 | 0.334 | 1.336
LED verte | Indicateur visuel | 0603 | - | -40°C to 85°C | Mouser | 696-SMLLXFP0603SUGCT | SML-LXFP0603SUGCTR | 2 | 0.169 | 0.338
Condensateur céramique 3.3uF | Filtrage/Découplage | 0805 | 10% | -55°C to 125°C | Mouser | 81-GRM21BR71C335KA9L | GRM21BR71C335KA99L | 2 | 0.578 | 1.156
Condensateur céramique 100pF | Filtrage/Découplage | 0603 | 1% | -55°C to 125°C | Mouser | 81-GRM185C1H101FA01J | GRM1885C1H101FA01J | 1 | 0.12 | 0.12
Condensateur céramique 100nF | Filtrage/Découplage | 0603 | 5% | -55°C to 125°C | Mouser | 81-GRM188R71E104JA1D | GRM188R71E104JA01D | 5 | 0.16 | 0.8
Condensateur céramique 1uF | Filtrage/Découplage | 0805 | 5% | -55°C to 125°C | Mouser | 81-GRM40X7R105J016AL | GRM21BR71C105JA01L | 4 | 0.229 | 0.916
Condensateur céramique 4.7uF | Filtrage/Découplage | 0805 | 10% | -55°C to 125°C | Mouser | 81-GRM21BR71C475KA73 | GRM21BR71C475KA73L | 3 | 0.568 | 1.704
Résistance 270 ohms | Résistance | 0805 | 1% | -55°C to 155°C | Mouser | 71-CRCW0805270RFKEAH | CRCW0805270RFKEAHP | 2 | 0.309 | 0.618
Total |  |  |  |  |  |  |  |  | 264.20 | [CHF]

Sheet: Blocs
Functional block | Function | # on bloc | Unit price | Price on board
Power Supply |  |  | Bloc price: | 4.17
USB Connectors 5P MINI TYPE B | Usb connector smd | 1 | 0.717 | 0.717
Condensateur céramique 4.7uF | Filtrage/Découplage | 1 | 0.568 | 0.568
Perle de ferrite | Protection EMC | 1 | 0.1 | 0.1
Header 3 positions | Change battery source | 1 | 0.279 | 0.279
Header 2rows 6positions 2.54mm | Connecteurs cartes | 2 | 0.239 | 0.478
Header 1row 2position 3mm | Connecteur Batterie | 1 | 1.03 | 1.03
Pointes de test | Signals measurement | 3 | 0.334 | 1.002
Current measurement |  |  | Bloc price: | 1.18
Résistance 0.1 ohms 0.5W | Current sense | 1 | 1.18 | 1.18
Amplifier |  |  | Bloc price: | 6.93
Condensateur céramique 100nF | Filtrage/Découplage | 1 | 0.16 | 0.16
OP184 | Ampli op | 1 | 6.04 | 6.04
Résistance 100 ohms | Résistance | 2 | 0.1 | 0.2
Résistance 20k | Résistance | 2 | 0.1 | 0.2
Pointes de test | Signals measurement | 1 | 0.334 | 0.334
Reference voltage 5V |  |  | Bloc price: | 18.22
Condensateur céramique 3.3uF | Filtrage/Découplage | 2 | 0.578 | 1.156
MAX865 | Doubleur de tension | 1 | 3.23 | 3.23
Condensateur Tantal 2.2uF | Filtrage/Découplage | 2 | 0.6074 | 1.2148
Condensateur Tantal 1uF | Filtrage/Découplage | 1 | 0.604 | 0.604
MAX6350 | Régulateur de tension 5V | 1 | 11.79 | 11.79
Condensateur céramique 1uF | Filtrage/Découplage | 1 | 0.229 | 0.229
Analogic to digital converter |  |  | Bloc price: | 225.80
Convertisseur A/D ADS1282-HT | Analogique to digital | 1 | 222.64 | 222.64
Résistance 1k | Résistance | 1 | 0.1 | 0.1
Condensateur Tantal 100uF | Filtrage/Découplage | 1 | 1.04 | 1.04
Condensateur céramique 100nF | Filtrage/Découplage | 3 | 0.16 | 0.48
Condensateur céramique 1uF | Filtrage/Découplage | 2 | 0.229 | 0.458
Résistance 75k | Résistance | 2 | 0.14 | 0.28
Résistance 47 ohms | Résistance | 8 | 0.1 | 0.8
DC/DC 3.3V converter |  |  | Bloc price: | 1.56
Condensateur céramique 1uF | Filtrage/Découplage | 1 | 0.229 | 0.229
Condensateur céramique 4.7uF | Filtrage/Découplage | 1 | 0.568 | 0.568
Résistance 75k | Résistance | 1 | 0.14 | 0.14
Résistance 24k | Résistance | 1 | 0.1 | 0.1
AP7361 | Convertisseur DC/DC Adj.1V to 5V | 1 | 0.524 | 0.524
USB to UART converter |  |  | Bloc price: | 6.33
Condensateur céramique 100pF | Filtrage/Découplage | 1 | 0.12 | 0.12
FTDI FT232RL | USB to UART | 1 | 4.53 | 4.53
LED verte | Indicateur visuel | 2 | 0.169 | 0.338
Condensateur céramique 100nF | Filtrage/Découplage | 1 | 0.16 | 0.16
Résistance 270 ohms | Résistance | 2 | 0.309 | 0.618
Condensateur céramique 4.7uF | Filtrage/Découplage | 1 | 0.568 | 0.568
Total |  |  | 264.20 | [CHF]
