Emilie16/HiRel/HiRelRapport_CourantTension_Maret_Gsponer/VerificationCircuitNumerique/matriceConformite.xls

Sheet: MatriceConformite
Requirement Id | Description | Testbench & Simulation setup | Simulation time occurrence | Validation method | Validation status (visa or remarks) | Appendix page
DS00-00000 | No floatting signals after reset | - | 0.02 us | Visual check | OK | DS00-00000
DS00-00001 | Output clock is between 1MHz and 4.096 MHz | - | 4.179 us | Visual check | NOK->Modif->OK | DS00-00001
DS00-00002 | Time between commands to ADC is min 24*ADC CLK | - | 127.789 us | Visual check | OK | DS00-00002
DS00-00003 | Voltage register can be read through AMBA bus | - | 230.37 us | Visual check | NOK->Modif->OK | DS00-00003
DS00-00004 | Current register can be read through AMBA bus | - | 230.15 us | Visual check | NOK->Modif->OK | DS00-00004
DS00-00005 | State machine can correct a false state | Need to be set in ahbAds1281_RTL.vhd | - | Visual check | OK | DS00-00005
DS00-00006 | ADC channel is readed at each enable | - | 119.99 us | Visual check | OK | DS00-00006
DS00-00007 | With a long enable signal, system make multipleADC acquisition | - | 599.99 us | Visual check | OK | DS00-00007
DS00-00008 | ADC channel change after each read | - | 119.99 us | Visual check | OK | DS00-00008
DS00-00009 | Reset is sync between AHB device and ADC | - | 0.02 us | Visual check | NOK->Modif->OK | DS00-00009

Sheet: DS00-00000
DS00-00000:
All I/O signals are in a defined state after the reset

Sheet: DS00-00001
DS00-00001:
Output clock is between 1MHz and 4.096 MHz | 0.3us = | 3333333.333 | Hz = | 3.33 | MHz
Note:
The clock can be configured by writing the modulatorClockDividerRegisterId through the AMBA bus. A protection has been implemented. If the written value
is to big than that not respect the clock range tolerance, the clock period is automatically set to 3.33MHz

Sheet: DS00-00002
DS00-00002:
Time between commands to ADC is min 24*ADC CLK | tCLK = | 0.3 us | time between command = | 9 us | clk between commandes = | 30
Note:
We wait 30 clock between command, the test is validated

Sheet: DS00-00003
DS00-00003:
Voltage register can be read through AMBA bus

Sheet: DS00-00004
DS00-00004:
Current register can be read through AMBA bus

Sheet: DS00-00005
DS00-00005:
State machine can correct a false state or bad sequence
Bit change in state => Correct correction
Bit change in state and wrong sequence => Correct correction
wrong sequence => Correct correction

Sheet: DS00-00006
DS00-00006:
ADC channel is readed at each enable
Note:
A complete cycle for reading ADC take 91.8 us. If enable period is lower than this value, the system
don't read as soon as desired.

Sheet: DS00-00007
DS00-00007:
With a long enable signal, system make multipleADC acquisition

Sheet: DS00-00008
DS00-00008:
ADC channel change after each read

Sheet: DS00-00009
DS00-00009:
Reset is sync between AHB device and ADC
