Emilie16/HiRel/HiRelRapport_CourantTension_Maret_Gsponer/WCA/result.xlsx

Sheet: 1
0.09900009446 | 200
0.09904013049 | 208
0.09908016651 | 207
0.09912020254 | 202
0.09916023856 | 216
0.09920027459 | 199
0.09924031062 | 182
0.09928034664 | 184
0.09932038267 | 226
0.0993604187 | 212
0.09940045472 | 201
0.09944049075 | 219
0.09948052678 | 197
0.0995205628 | 197
0.09956059883 | 195
0.09960063486 | 193
0.09964067088 | 181
0.09968070691 | 204
0.09972074294 | 204
0.09976077896 | 209
0.09980081499 | 173
0.09984085101 | 212
0.09988088704 | 208
0.09992092307 | 193
0.09996095909 | 198
0.1000009951 | 208
0.1000410311 | 190
0.1000810672 | 188
0.1001211032 | 203
0.1001611392 | 206
0.1002011753 | 234
0.1002412113 | 186
0.1002812473 | 206
0.1003212833 | 189
0.1003613194 | 204
0.1004013554 | 198
0.1004413914 | 202
0.1004814274 | 207
0.1005214635 | 213
0.1005614995 | 207
0.1006015355 | 183
0.1006415715 | 206
0.1006816076 | 201
0.1007216436 | 200
0.1007616796 | 216
0.1008017156 | 202
0.1008417517 | 192
0.1008817877 | 184
0.1009218237 | 196
0.1009618598 | 159
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
