Emilie16/HiRel/HiRelRapport_CourantTension_Maret_Gsponer/SchemaBloc/SchemaBloc.pdf

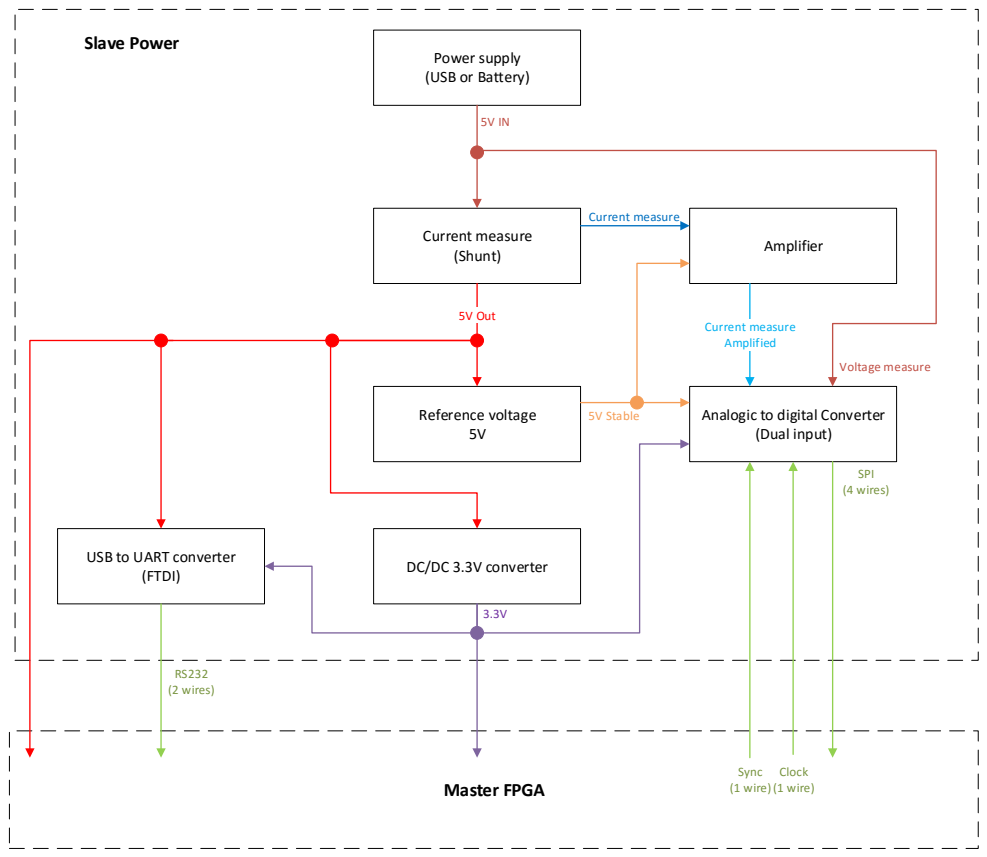
[picture p64: page 1]
Current measure (Shunt); (Dual input); Reference voltage 5V; Amplifier; Current measure; 5V Stable; Voltage measure; (FTDI); Master FPGA; RS232 (2 wires); SPI (4 wires); Sync (1 wire); Clock (1 wire); Slave Power

Power supply
(USB or Battery)

5V Out

Current measure Amplified

Analogic to digital Converter

USB to UART converter

DC/DC 3.3V converter
