Emilie16/HiRel/HiRelRapport_CourantTension_Maret_Gsponer/VHDL/MachineEtat/vhdlFSM.pdf

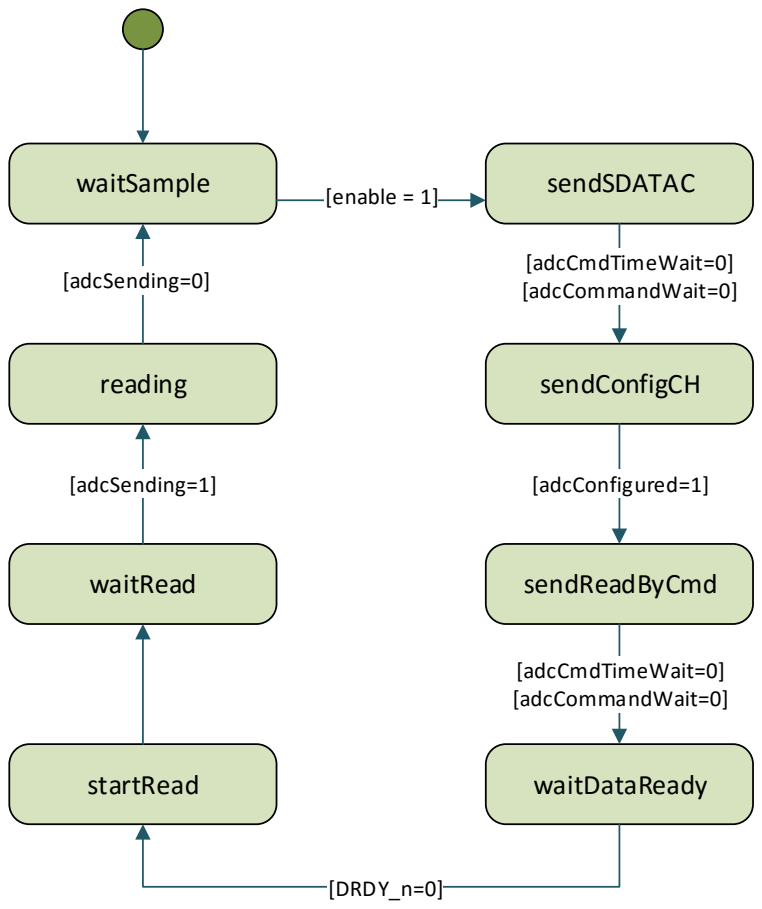
[picture p65: page 1]
waitSample; sendSDATAC; startRead; waitDataReady; waitRead; reading; sendConfigCH; sendReadByCmd; [enable = 1]; [adcCmdTimeWait=0] [adcCommandWait=0]; [adcConfigured=1]; [DRDY_n=0]; [adcSending=1]; [adcSending=0]
