Emilie16/HiRel/HiRelRapport_CourantTension_Maret_Gsponer/DissipationChaleur/dissipationChaleur.asc

C1J/Cdemi: cap; 0.95
C1PCBdemi: cap; 4
C2J/Cdemi: cap; 0.95
C2PCBdemi: cap; 4
PDiss: current; 0
RC/PCB: res; 12.6
RJ/C: res; 24.04
RPCB/SC: res; 0.16
RPCB: res; 0.061
TSC: voltage; ""; AC 1
Named nets: 0, TJ
.ac oct 100 0.00001 100
