Emilie16/HiRel/HiRelRapport_CourantTension_Maret_Gsponer/EffetRadiations/RegistreADecalage/shiftReg.asc

A1: dflop
A2: dflop
A3: dflop
A4: dflop
A5: and
A6: and
A7: and
A8: dflop
A9: and
A10: dflop
A11: dflop
A12: dflop
A13: and
A14: and
A15: and
A16: and
A17: dflop
A18: dflop
A19: dflop
A20: dflop
A21: and
A22: and
A23: and
A24: and
A25: and
A26: and
A27: and
A28: or
A29: and
A30: and
A31: and
A32: or
A33: and
A34: and
A35: and
A36: or
A37: and
A38: and
A39: and
A40: or
B1: bv; V=delay(V(q2),0.1)
B2: bv; V=delay(V(q1),0.1)
B3: bv; V=delay(V(q3),0.1)
V2: voltage; PWL(0 0 0.8 0 0.81 1)
V3: voltage; PULSE(0 1 0.1 0 0 0.4 0.8 6)
V4: voltage; PWL(0 0 1.6 0 1.61 1 3.2 1 3.21 0)
V5: voltage; PULSE(0 1 0 0 0 0.2 0.4 20)
Named nets: 0, Q1a, Q2a, Q3a, Q4a, SHIFT_EN, SIGNAL, RESET, CLK, Q2delay, Q1delay, Q3delay, Q1b, Q2b, Q4b, Q1c, Q2c, Q3c, Q4c, Q1, Q2, Q3, Q3b, Q4
.tran 0 6.5 0 0.1
