Emilie16/HiRel/HiRelRapport_CourantTension_Maret_Gsponer/Simulation/chargeVariable/chargeVariable.asc

C1: cap; 0.1µ
Load: res; {R}
R1: res; 20k
R2: res; 100
R3: res; 100
R4: res; 20k
Shunt: res; 0.1
U1: OP184
V1: voltage; 5
Named nets: 0, Vcc, Vcurrent, VCC
.op
.step param R 30 2000 5
