Emilie16/HiRel/HiRelRapport_CourantTension_Maret_Gsponer/Simulation/courantSinus/courantSinus.asc

C1: cap; 0.1µ
Load: res; 40
R1: res; 20k
R2: res; 100
R3: res; 100
R4: res; 20k
Shunt: res; 0.1
U1: OP184
V1: voltage; SINE(4.8 0.4 1)
V2: voltage; 5
Named nets: 0, Vcc, Vcurrent, VCC
.tran 20
