Emilie16/HiRel/HiRelRapport_CourantTension_Maret_Gsponer/Simulation/dechargeBatterie/dechargeBatterie.asc

C1: cap; 0.1µ
Load: res; 25
R1: res; 20k
R2: res; 100
R3: res; 100
R4: res; 20k
Shunt: res; 0.1
U1: OP184
V1: voltage; {V}
Named nets: 0, Vcc, Vcurrent, VCC
.op
.step param V 0 5 0.1
