Emilie16/HiRel/HiRelRapport_CourantTension_Maret_Gsponer/VHDL/CanSat/AhbLiteComponents_test/hds/ads1282/test.vhd

ARCHITECTURE test OF DAC_5543 IS
  signal serialRegister: unsigned(15 downto 0);
BEGIN

  shiftRegister: process(CLK)
  begin
    if (CS_n = '0') and rising_edge(CLK) then
      serialRegister(serialRegister'high downto 1) <= serialRegister(serialRegister'high-1 downto 0);
      serialRegister(0) <= SDI;
    end if;
  end process shiftRegister;

  dacRegister: process(CS_n)
  begin
    if rising_edge(CS_n) then
      Iout <= to_integer(to_01(serialRegister));
    end if;
  end process dacRegister;

END test;
