Emilie16/HiRel/(commit log)

2016-03-17 Bien avancé la simulation
2016-03-23 Schema bloc et liste de taches
2016-03-29 Budget mass
    [Budgets.xls]
2016-03-29 add schematic
2016-03-29 update schematic and add performance analysis
2016-03-29 Fini budget
    [Budgets.xls]
2016-03-29 Fini analyse monte carlo. + organiser dossier
    [AnalyseMonteCarlo_Shunt.xls, result1.xlsx, result2.xlsx]
2016-04-06 ajout des risques (FMECA)
2016-04-07 Refait Schéma Bloc
    [AnalyseMonteCarlo_Shunt.xls, Budgets.xls]
2016-04-12 Documentation des simulations
    [Budgets.xls]
2016-04-21 Finit bugdet. Modifié les résistances des LED à 100 ohms.
    [Budgets.xls]
2016-04-22 Avancement rapport, fini budget, fini analyse Monte Carlo. Rechangé résistance des LEDs
    [AnalyseMonteCarlo_Shunt.xls, Budgets.xls, result.xlsx, result1.xlsx, result2.xlsx]
2016-05-17 Analyse taux SEU
    [seu.xls]
2016-05-25 add psa analysis
    [Table_PSA.xls]
2016-05-25 add circuitmaker folder for schematique and pcb
2016-05-25 add schematic and PCB report with gallery
2016-05-29 Modifié structure du rapport, complété TODOList avec toutes les tâches, Préparé le dossier de rendu
    [AnalyseMonteCarlo_Shunt.xls, Budgets.xls, result.xlsx]
2016-05-29 Modifié liste de tâches, modifié VHDL, machine d'état résistance SEU, matrice de conformité, Fini canevas rapport
    [SEU.xls, matriceConformite.xls, seu.xls]
2016-06-01 Modifier analyse monte carlo
    [AnalyseMonteCarlo_Shunt.xls, result.xlsx]
2016-06-05 update psa table
    [Table_PSA.xls]
2016-06-05 add fra analysis
    [Rel_components.xls]
2016-06-06 update FMECA
    [fmeca_table.xlsx]
2016-06-06 update routage and schematic
2016-06-08 Intégré tout dans un seul rapport. A relire
    [Rel_components.xls, Table_PSA.xls, fmeca_table.xlsx]
2016-06-09 Fini relecture du rapport. Deux parties en rouge à modifier ou m'expliquer
    [Classeur1.xlsx]
2016-06-12 corrigé erreur SEU
    [SEU.xls]
